XDecoder12/stm32-maze-solving-robot/images_videos/Schematics Image.jpeg

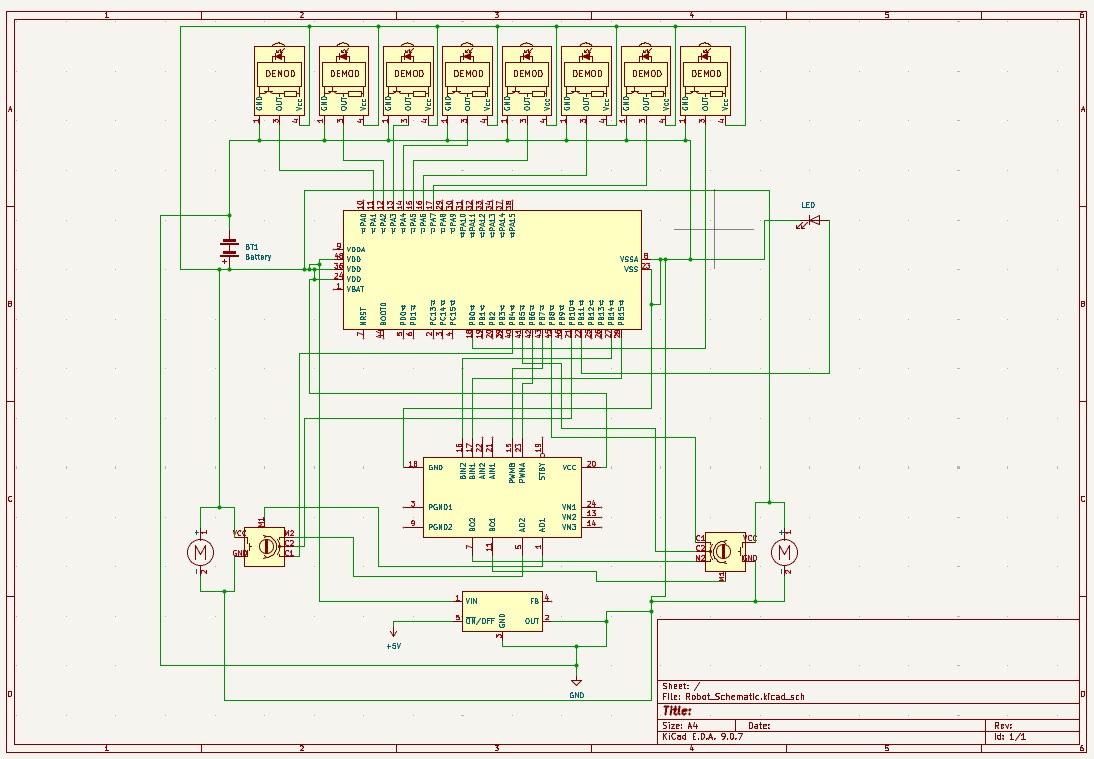
images_videos/Schematics Image.jpeg
