XDecoder12/stm32-maze-solving-robot/(commit log)

2025-11-01 Add README for STM32 Maze-Solving Robot project
    Added detailed project description, hardware components and software setup instructions for the STM32 maze-solving robot.
2025-11-02 Corrected the correction direction error
    [code.ino]
2026-09-15 Revise README for clarity and accuracy
    Updated maze solving algorithm description and clarified limitations. Corrected hardware input pin references and improved formatting.
2026-10-10 docs: add detailed STM32 robot system architecture
